Space-Pickles/2025-Electrical-2/vanguard/patrick/tardon/tardon/imports/MPU-6000/MPU-6000.step

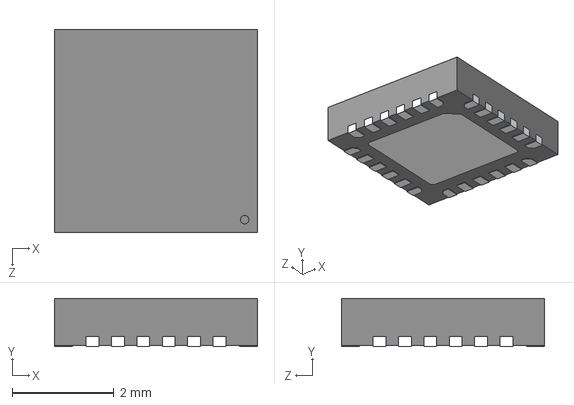
[picture p1: CAD file, 2025-04-15]
vanguard/patrick/tardon/tardon/imports/MPU-6000/MPU-6000.step
4.00 x 0.95 x 4.00 mm
