Space-Pickles/2025-Electrical-2/vanguard/board versions/Vang_V2.3.4/Vanguard_new.kicad_pcb

## KiCad design vanguard/board versions/Vang_V2.3.4/Vanguard_new.kicad_pcb (2025-05-21, an earlier design)

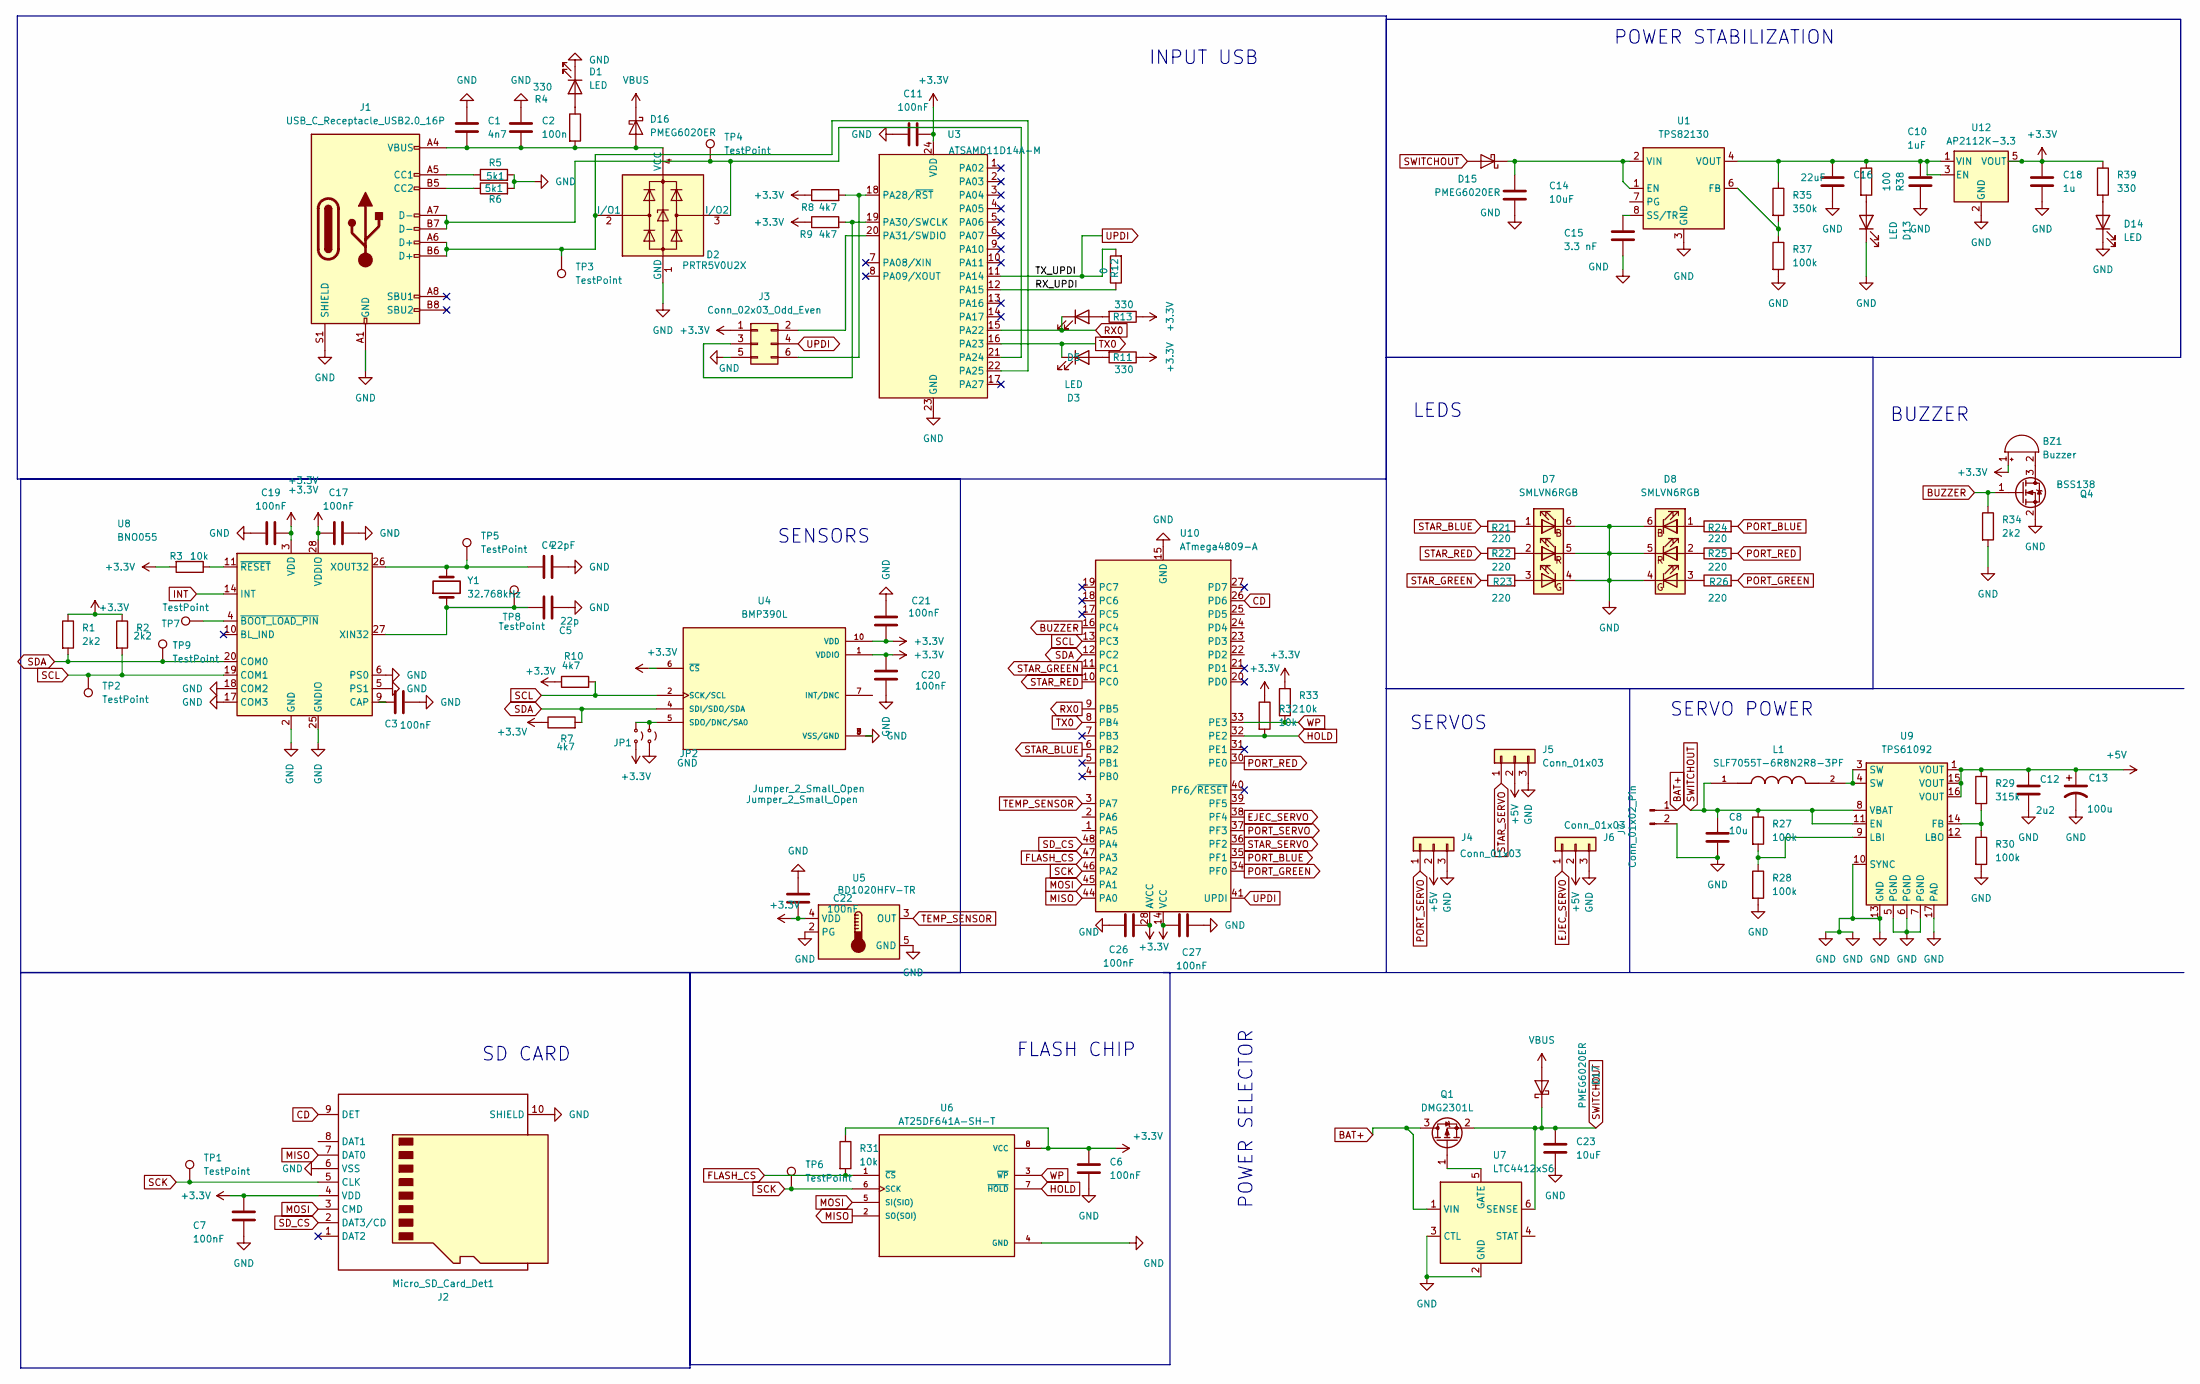
[picture p2: schematic Vanguard_new.kicad_sch]

Parts:
BZ1: Buzzer; MagneticBuzzer_PUI_AT-0927-TT-6-R
C1: 4n7; C_0603_1608Metric
C2: 100n; C_0603_1608Metric
C3, C6, C7, C11, C17, C19, C20, C21, C22, C26, C27: 100nF; C_0603_1608Metric
C4: 22pF; C_0603_1608Metric
C5: 22p; C_0603_1608Metric
C8: 10u; C_0603_1608Metric
C10: 1uF; C_0603_1608Metric
C12: 2u2; C_0603_1608Metric
C13: 100u; CP_Radial_D4.0mm_P2.00mm
C14, C23: 10uF; C_0603_1608Metric
C15: 3.3 nF; C_0603_1608Metric
C16: 22uF; C_0603_1608Metric
C18: 1u; C_0603_1608Metric
D1, D3, D5, D13, D14: LED; LED_0603_1608Metric
D2: PRTR5V0U2X; SOT-143
D7, D8: SMLVN6RGB; LED_ROHM_SMLVN6
D15, D16, D17: PMEG6020ER; Nexperia_CFP3_SOD-123W
J1: USB_C_Receptacle_USB2.0_16P; USB_C_Receptacle_Amphenol_124019772112A
J2: Micro_SD_Card_Det1; microSD_HC_Hirose_DM3D-SF
J3: Conn_02x03_Odd_Even; PinHeader_2x03_P2.54mm_Vertical
J4, J5, J6: Conn_01x03; PinHeader_1x03_P2.54mm_Vertical
J7: Conn_01x02_Pin; JST_PH_B2B-PH-K_1x02_P2.00mm_Vertical
JP1, JP2: Jumper_2_Small_Open; SolderJumper-2_P1.3mm_Open_Pad1.0x1.5mm
L1: SLF7055T-6R8N2R8-3PF; L_7.3x7.3_H4.5; PARTREV N/A
Q1: DMG2301L; SOT-23
Q4: BSS138; SOT-23
R1, R2, R34: 2k2; R_0603_1608Metric
R3, R31, R32, R33: 10k; R_0603_1608Metric
R4, R11, R13, R39: 330; R_0603_1608Metric
R5, R6: 5k1; R_0603_1608Metric
R7, R8, R9, R10: 4k7; R_0603_1608Metric
R12: 0; R_0603_1608Metric
R21, R22, R23, R24, R25, R26: 220; R_0603_1608Metric
R27, R28, R30, R37: 100k; R_0603_1608Metric
R29: 315k; R_0603_1608Metric
R35: 350k; R_0603_1608Metric
R38: 100; R_0603_1608Metric
TP1, TP2, TP3, TP4, TP5, TP6, TP7, TP8, TP9: TestPoint; TestPoint_Pad_1.0x1.0mm
U1: TPS82130; Texas_SIL0008D_MicroSiP-8-1EP_2.8x3mm_P0.65mm_EP1.1x1.9mm_T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
U3: ATSAMD11D14A-M; QFN-24-1EP_4x4mm_P0.5mm_EP2.6x2.6mm
U4: BMP390L; ST_HLGA-10_2x2mm_P0.5mm_LayoutBorder3x2y; PARTREV 1.7
U5: BD1020HFV-TR; HVSOF5
U6: AT25DF641A-SH-T; SOIC-8_3.9x4.9mm_P1.27mm; PARTREV 06-2020
U7: LTC4412xS6; TSOT-23-6
U8: BNO055; LGA-28_5.2x3.8mm_P0.5mm
U9: TPS61092; Texas_RSA_VQFN-16-1EP_4x4mm_P0.65mm_EP2.7x2.7mm_ThermalVias
U10: ATmega4809-A; TQFP-48_7x7mm_P0.5mm
U12: AP2112K-3.3; SOT-23-5
Y1: 32.768kHz; Crystal_C26-LF_D2.1mm_L6.5mm_Vertical

Connections:
+5V: C12.1, C13.1, J4.2, J5.2, J6.2, R29.1, U9.1 (VOUT), U9.15 (VOUT), U9.16 (VOUT)
/RX_UPDI: R12.1, U3.12 (PA15)
BAT+: J7.1, Q1.3 (D), U7.1 (VIN)
BUZZER: Q4.1 (G), R34.1, U10.16 (PC4)
CD: J2.9 (DET), U10.26 (PD6)
EJEC_SERVO: J6.1, U10.38 (PF4)
FLASH_CS: R31.2, U6.1 (~CS), U10.47 (PA3)
HOLD: R32.2, U6.7 (~HOLD), U10.32 (PE2)
INT: U8.14 (INT)
MISO: J2.7 (DAT0), U6.2 (SO(SOI)), U10.44 (PA0)
MOSI: J2.3 (CMD), U6.5 (SI(SIO)), U10.45 (PA1)
unnamed: BZ1.2 (-), Q4.3 (D)
unnamed: D1.2 (A), R4.1
unnamed: D2.2 (I/O1), J1.A6 (D+), J1.B6 (D+), TP3.1, U3.22 (PA25)
unnamed: D2.3 (I/O2), J1.A7 (D-), J1.B7 (D-), TP4.1, U3.21 (PA24)
unnamed: D3.2 (A), R11.2
unnamed: D5.2 (A), R13.2
unnamed: D7.1 (BA), R21.2
unnamed: D7.3 (GA), R23.2
unnamed: D7.2 (RA), R22.2
unnamed: D8.1 (BA), R24.1
unnamed: D8.3 (GA), R26.1
unnamed: D8.2 (RA), R25.1
unnamed: D13.2 (A), R38.2
unnamed: D14.2 (A), R39.2
unnamed: C14.1, D15.1 (K), U1.1 (EN), U1.2 (VIN)
unnamed: C1.2, C2.2, D2.4 (VCC), D16.2 (A), J1.A4 (VBUS), J1.A9 (VBUS), J1.B4 (VBUS), J1.B9 (VBUS), R4.2
unnamed: J1.A5 (CC1), R5.1
unnamed: J1.B5 (CC2), R6.1
unnamed: J3.2, U3.20 (PA31/SWDIO)
unnamed: J3.3, R9.2, U3.19 (PA30/SWCLK)
unnamed: J3.6, R8.2, U3.18 (PA28/~RST)
unnamed: JP1.1 (A), JP2.1 (A), U4.5 (SDO/DNC/SA0)
unnamed: L1.2, U9.3 (SW), U9.4 (SW)
unnamed: Q1.1 (G), U7.5 (GATE)
unnamed: R35.2, R37.1, U1.6 (FB)
unnamed: C15.1, U1.8 (SS/TR)
unnamed: C3.1, U8.9 (CAP)
unnamed: C5.1, TP8.1, U8.27 (XIN32), Y1.1
unnamed: C4.1, TP5.1, U8.26 (XOUT32), Y1.2
unnamed: TP7.1, U8.4 (~BOOT_LOAD_PIN)
unnamed: R3.1, U8.11 (~RESET)
unnamed: R29.2, R30.1, U9.14 (FB)
unnamed: R27.2, R28.1, U9.9 (LBI)
unnamed: C10.1, C16.1, R35.1, R38.1, U1.4 (VOUT), U1.5 (VOUT), U12.1 (VIN), U12.3 (EN)
PORT_BLUE: R24.2, U10.35 (PF1)
PORT_GREEN: R26.2, U10.34 (PF0)
PORT_RED: R25.2, U10.30 (PE0)
PORT_SERVO: J4.1, U10.37 (PF3)
RX0: D5.1 (K), U3.15 (PA22), U10.9 (PB5)
SCK: J2.5 (CLK), TP1.1, TP6.1, U6.6 (SCK), U10.46 (PA2)
SCL: R2.2, R10.2, TP2.1, U4.2 (SCK/SCL), U8.19 (COM1), U10.13 (PC3)
SDA: R1.2, R7.2, TP9.1, U4.4 (SDI/SDO/SDA), U8.20 (COM0), U10.12 (PC2)
SD_CS: J2.2 (DAT3/CD), U10.48 (PA4)
STAR_BLUE: R21.1, U10.6 (PB2)
STAR_GREEN: R23.1, U10.11 (PC1)
STAR_RED: R22.1, U10.10 (PC0)
STAR_SERVO: J5.1, U10.36 (PF2)
SWITCHOUT: C8.1, C23.1, D15.2 (A), D17.1 (K), L1.1, Q1.2 (S), R27.1, U7.6 (SENSE), U9.8 (VBAT), U9.11 (EN)
TEMP_SENSOR: U5.3 (OUT), U10.3 (PA7)
TX0: D3.1 (K), U3.16 (PA23), U10.8 (PB4)
UPDI: J3.4, R12.2, U3.11 (PA14), U10.41 (UPDI)
VBUS: D16.1 (K), D17.2 (A)
WP: R33.2, U6.3 (~WP), U10.33 (PE3)

Notes on the sheet:
BUZZER
SENSORS
POWER SELECTOR
SD CARD
INPUT USB
SERVOS
FLASH CHIP
LEDS
POWER STABILIZATION
SERVO POWER

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
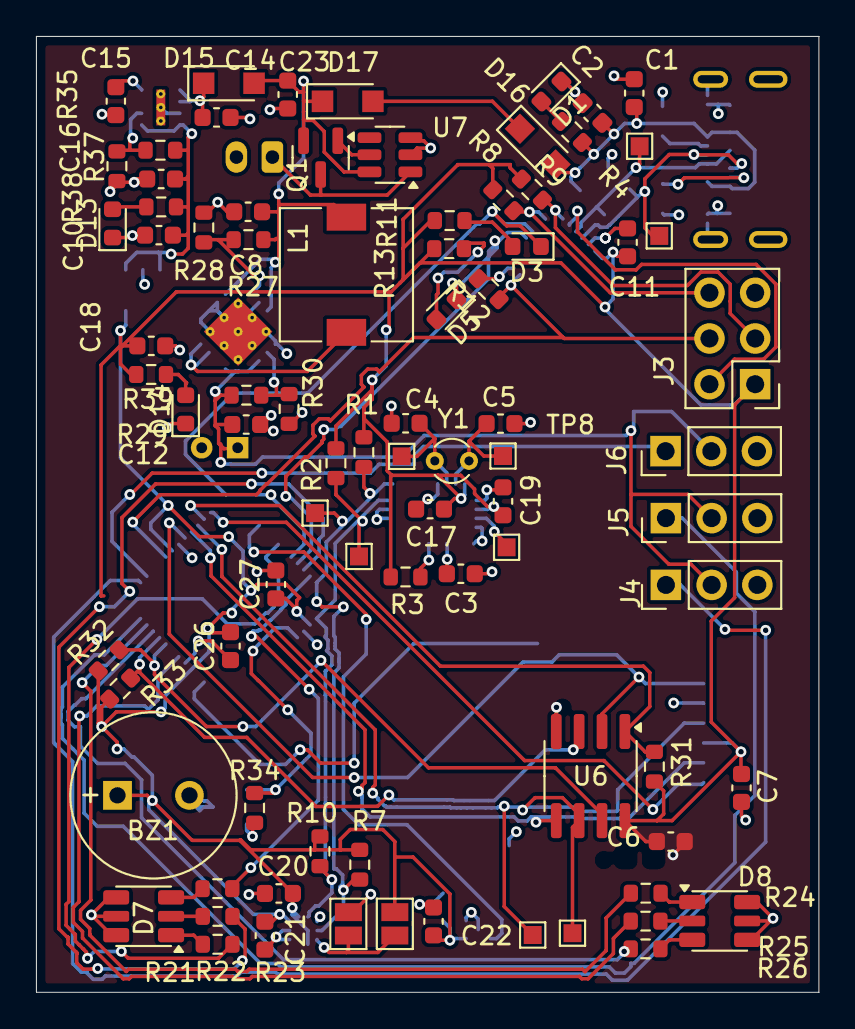
[picture p3: board vanguard/board versions/Vang_V2.3.4/Vanguard_new.kicad_pcb from above]

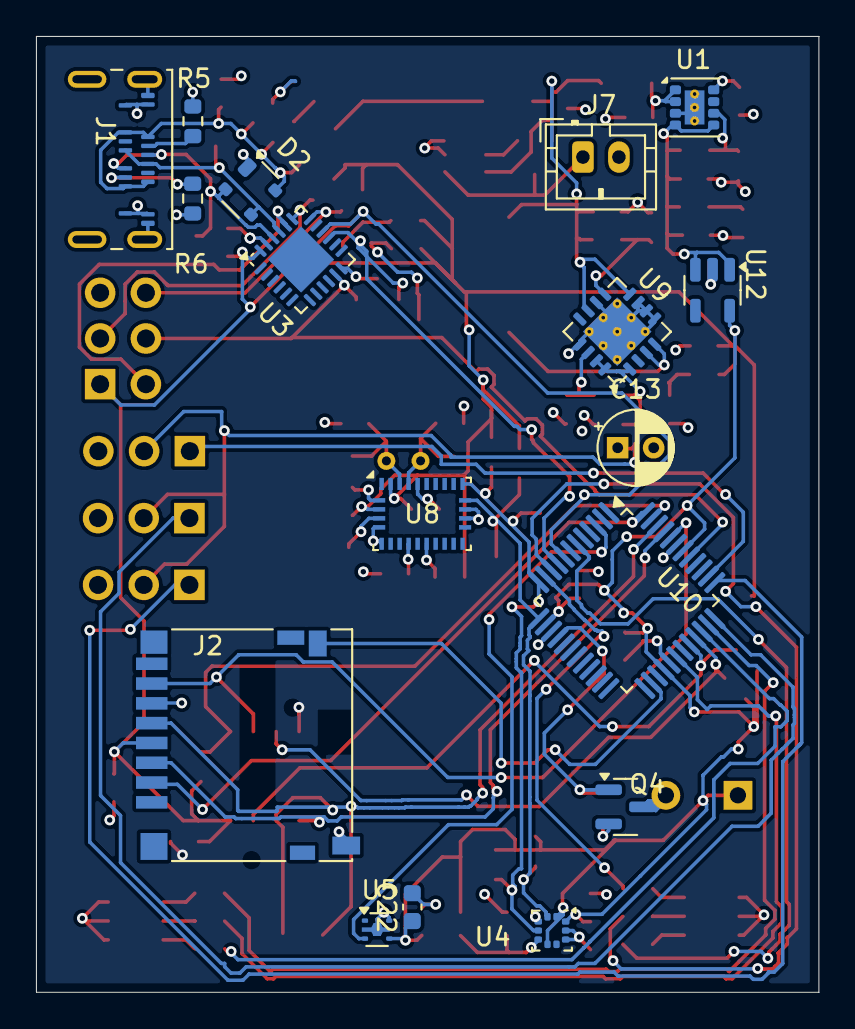
[picture p4: board vanguard/board versions/Vang_V2.3.4/Vanguard_new.kicad_pcb from below]

Board: 4 copper layers, 43.5 x 53.1 mm, 100 parts (17 on the bottom side), 65 nets.

Other parts of the board:
C22#2: 100nF; C_0603_1608Metric
