Space-Pickles/2025-Electrical-2/vanguard/patrick/Launch system/Vanguard_new.kicad_pcb

## KiCad design vanguard/patrick/Launch system/Vanguard_new.kicad_pcb (2025-04-29)

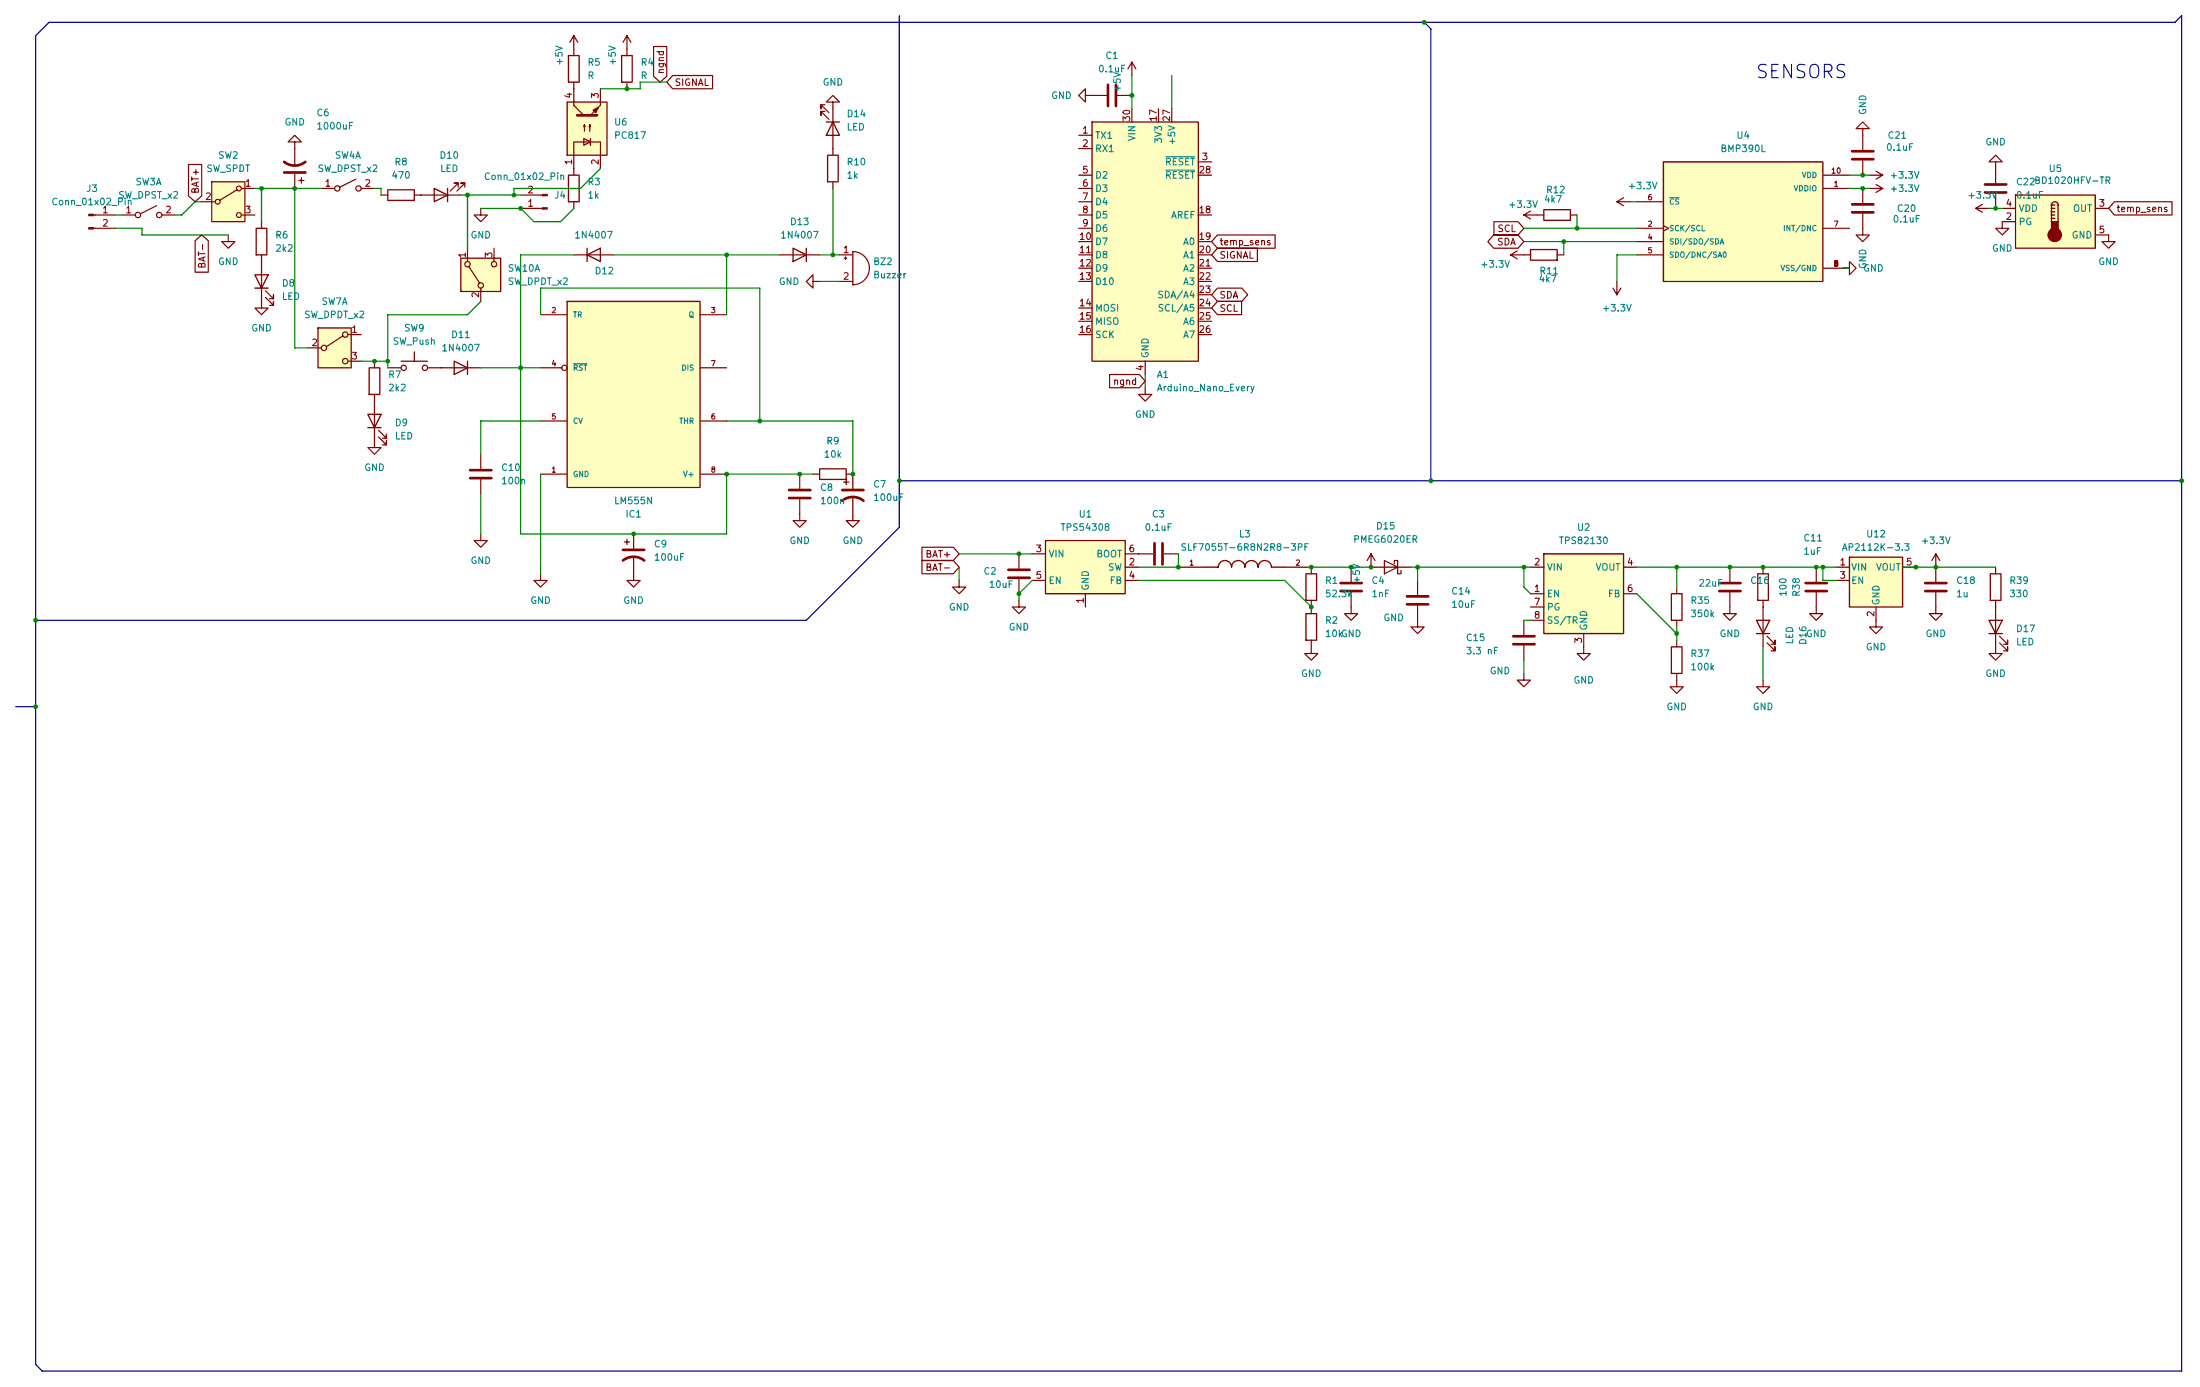
[picture p5: schematic Vanguard_new.kicad_sch]

Parts:
A1: Arduino_Nano_Every; Arduino_Nano
BZ2: Buzzer; Buzzer_12x9.5RM7.6
C1, C3, C20, C21, C22: 0.1uF; C_0805_2012Metric
C2, C14: 10uF; C_0805_2012Metric
C4: 1nF; C_0805_2012Metric
C6: 1000uF; C_0805_2012Metric
C7, C9: 100uF; C_0805_2012Metric
C8, C10: 100n; C_0805_2012Metric
C11: 1uF; C_0805_2012Metric
C15: 3.3 nF; C_0805_2012Metric
C16: 22uF; C_0805_2012Metric
C18: 1u; C_0805_2012Metric
D8, D9, D10, D14: LED; LED_D3.0mm
D11, D12, D13: 1N4007; D_SOD-123F
D15: PMEG6020ER; Nexperia_CFP3_SOD-123W
D16, D17: LED; LED_0201_0603Metric
IC1: LM555N; SOIC-8_3.9x4.9mm_P1.27mm
J3: Conn_01x02_Pin; AMASS_XT60-F_1x02_P7.20mm_Vertical
J4: Conn_01x02_Pin; PinSocket_1x02_P2.54mm_Vertical
L3: SLF7055T-6R8N2R8-3PF; L_7.3x7.3_H4.5; PARTREV N/A
R1: 52.3k; R_0805_2012Metric
R2, R9: 10k; R_0805_2012Metric
R3, R10: 1k; R_0805_2012Metric
R4, R5: R; R_0805_2012Metric
R6, R7: 2k2; R_0805_2012Metric
R8: 470; R_0805_2012Metric
R11, R12: 4k7; R_0805_2012Metric
R35: 350k; R_0805_2012Metric
R37: 100k; R_0805_2012Metric
R38: 100; R_0805_2012Metric
R39: 330; R_0805_2012Metric
SW2: SW_SPDT; PinHeader_1x03_P2.54mm_Vertical
SW3, SW4: SW_DPST_x2; PinHeader_1x02_P2.54mm_Vertical
SW7, SW10: SW_DPDT_x2; PinHeader_1x03_P2.54mm_Vertical
SW9: SW_Push; PinHeader_1x02_P2.54mm_Vertical
U1: TPS54308; SOT-23-6
U2: TPS82130; Texas_SIL0008D_MicroSiP-8-1EP_2.8x3mm_P0.65mm_EP1.1x1.9mm_T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
U4: BMP390L; ST_HLGA-10_2x2mm_P0.5mm_LayoutBorder3x2y; PARTREV 1.7
U5: BD1020HFV-TR; HVSOF5
U6: PC817; DIP-4_W7.62mm
U12: AP2112K-3.3; SOT-23-5

Connections:
+3.3V: C18.1, C20.2, C21.1, C22.2, R11.1, R12.1, R39.1, U4.1 (VDDIO), U4.5 (SDO/DNC/SA0), U4.6 (~CS), U4.10 (VDD), U5.4 (VDD), U12.5 (VOUT)
+5V: A1.30 (VIN), C1.2, C4.1, D15.2 (A), L3.2, R1.1, R4.1, R5.1
BAT+: C2.1, SW2.2 (B), SW3.2 (B), U1.3 (VIN)
BAT-: A1.4 (GND), A1.20 (A1), A1.29 (GND), BZ2.2 (-), C1.1, C2.2, C4.2, C6.2, C7.2, C8.2, C9.2, C10.2, C11.2, C14.2, C15.2, C16.2, C18.2, C20.1, C21.2, C22.1, D8.1 (K), D9.1 (K), D14.1 (K), D16.1 (K), D17.1 (K), IC1.1 (GND), J3.2, J4.1, R2.2, R3.2, R4.2, R37.2, U1.5 (EN), U2.3 (GND), U2.9 (GND), U4.3 (VSS/GND), U4.8 (VSS/GND), U4.9 (VSS/GND), U5.2 (PG), U5.5 (GND), U6.3, U12.2 (GND)
unnamed: BZ2.1 (+), D13.1 (K), R10.2
unnamed: D8.2 (A), R6.2
unnamed: D9.2 (A), R7.2
unnamed: D10.2 (A), R8.2
unnamed: D10.1 (K), J4.2, SW10.1 (A), U6.2
unnamed: D11.2 (A), SW9.2
unnamed: C8.1, C9.1, D11.1 (K), D12.1 (K), IC1.4 (~RST), IC1.8 (V+), R9.1
unnamed: D12.2 (A), D13.2 (A), IC1.3 (Q)
unnamed: D14.2 (A), R10.1
unnamed: C14.1, D15.1 (K), U2.1 (EN), U2.2 (VIN)
unnamed: D16.2 (A), R38.2
unnamed: D17.2 (A), R39.2
unnamed: C10.1, IC1.5 (CV)
unnamed: C7.1, IC1.2 (TR), IC1.6 (THR), R9.2
unnamed: J3.1, SW3.1 (A)
unnamed: R3.1, U6.1
unnamed: R5.2, U6.4
unnamed: C6.1, R6.1, SW2.1 (A), SW4.1 (A), SW7.2 (B)
unnamed: R8.1, SW4.2 (B)
unnamed: R7.1, SW7.3 (C), SW9.1, SW10.2 (B)
unnamed: C3.1, U1.6 (BOOT)
unnamed: R1.2, R2.1, U1.4 (FB)
unnamed: C3.2, L3.1, U1.2 (SW)
unnamed: R35.2, R37.1, U2.6 (FB)
unnamed: C15.1, U2.8 (SS/TR)
unnamed: C11.1, C16.1, R35.1, R38.1, U2.4 (VOUT), U2.5 (VOUT), U12.1 (VIN), U12.3 (EN)
SCL: A1.24 (SCL/A5), R12.2, U4.2 (SCK/SCL)
SDA: A1.23 (SDA/A4), R11.2, U4.4 (SDI/SDO/SDA)
temp_sens: A1.19 (A0), U5.3 (OUT)

Notes on the sheet:
SENSORS

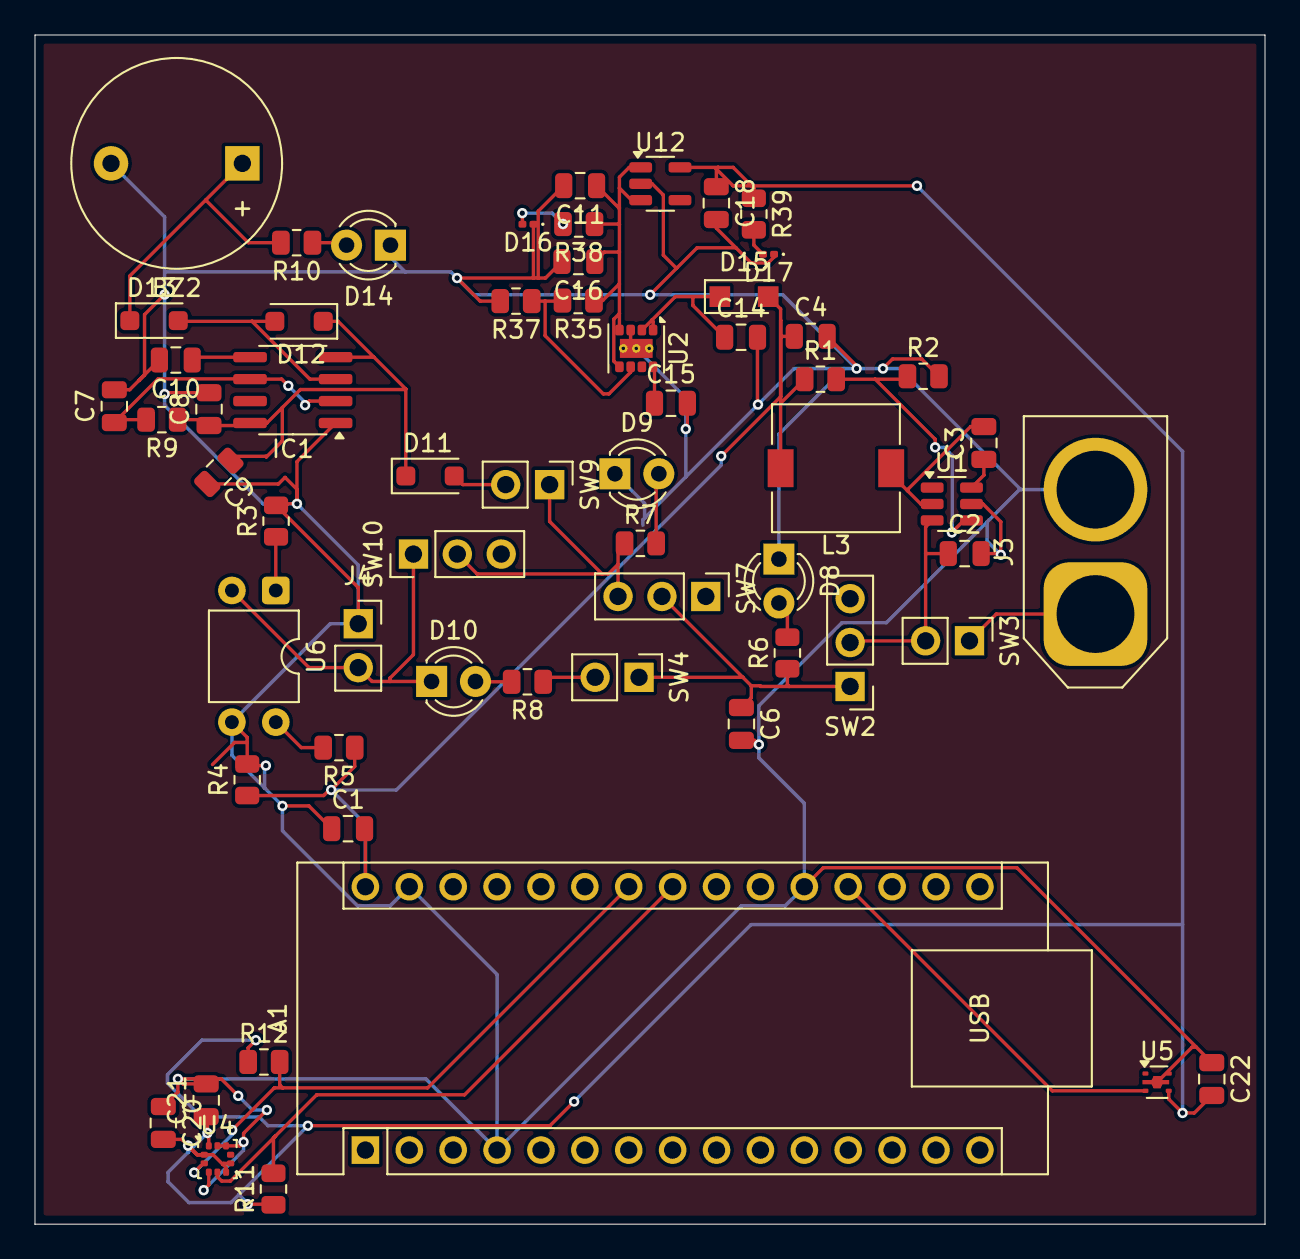
[picture p6: board vanguard/patrick/Launch system/Vanguard_new.kicad_pcb from above]

Board: 2 copper layers, 71.2 x 68.8 mm, 61 parts (0 on the bottom side), 33 nets.
