Space-Pickles/2025-Electrical-2/vanguard/board versions/Vang_V2.3.1/Vanguard_new.kicad_pcb

## KiCad design vanguard/board versions/Vang_V2.3.1/Vanguard_new.kicad_pcb (2025-02-10, an earlier design)

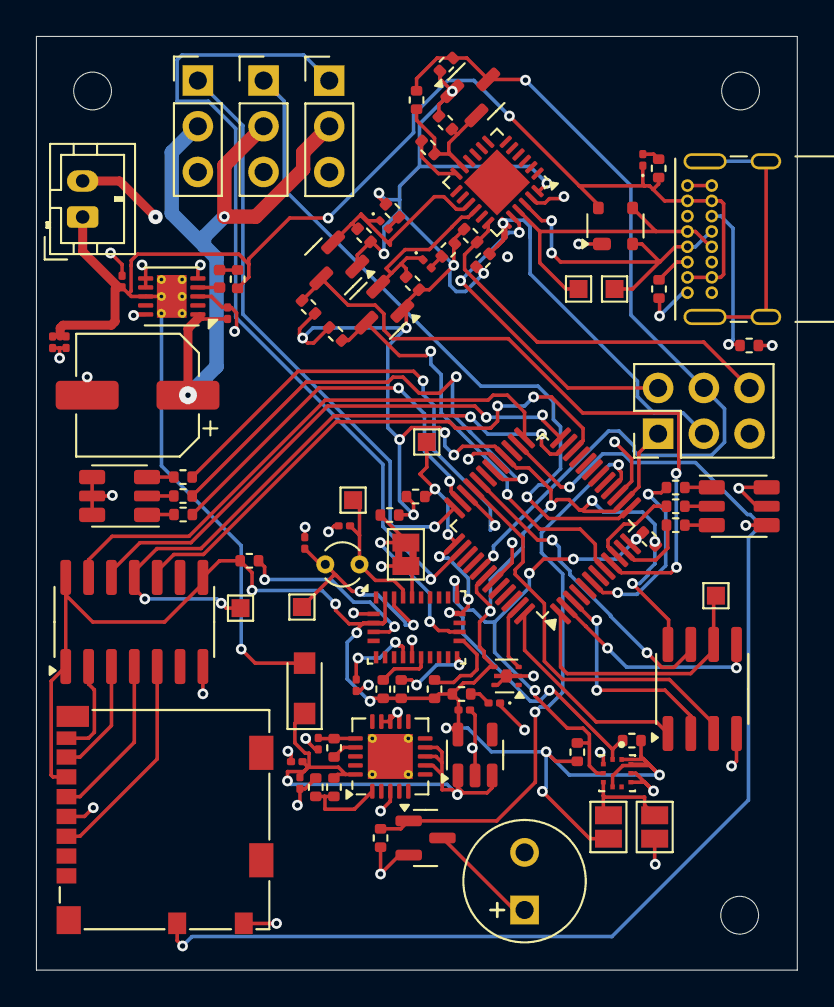
[picture p7: board vanguard/board versions/Vang_V2.3.1/Vanguard_new.kicad_pcb from above]

Board: 4 copper layers, 42.3 x 51.9 mm, 90 parts (0 on the bottom side), 72 nets.

Parts:
ADR1: SolderJumper-2_P1.3mm_Bridged2Bar_Pad1.0x1.5mm
BZ1: Buzzer; MagneticBuzzer_Kingstate_KCG0601
C2, C3: 22p; C_0201_0603Metric
C4, C5: 22u; C_0201_0603Metric
C6, C11: 1u; C_0201_0603Metric
C7: 0u1; C_0201_0603Metric
C8: 10u; C_0201_0603Metric
C9: 2u2; C_0201_0603Metric
C10: 100u; CP_Elec_6.3x5.4
C12: 4n7; C_0201_0603Metric
C13: 100n; C_0201_0603Metric
D1: PRTR5V0U2X; SOT-143
D2, D3, D7: LED; LED_0201_0603Metric
D5: GREEN; LED_0201_0603Metric
D6: PMEG6020ER; Nexperia_CFP3_SOD-123W
J1: USB_C_Receptacle_USB2.0_16P; USB_C_Receptacle_GCT_USB4085
J2: Conn_02x03_Pin; PinHeader_2x03_P2.54mm_Vertical
J3: Micro_SD_Card_Det1; microSD_HC_Molex_104031-0811
J4: STARBOARD_SERVO; PinHeader_1x03_P2.54mm_Vertical
J5: PORTSIDE_SERVO; PinHeader_1x03_P2.54mm_Vertical
J6: Battery In; JST_PH_B2B-PH-K_1x02_P2.00mm_Vertical
J7: EJECTION_SERVO; PinHeader_1x03_P2.54mm_Vertical
JP1, JP2: Jumper_2_Small_Open; SolderJumper-2_P1.3mm_Open_Pad1.0x1.5mm
L1: 6u8; L_0402_1005Metric
PORTSIDE_RGB1: SMLVN6RGB; LED_ROHM_SMLVN6
Q1, Q2, Q3, Q4: BSS138; SOT-23
R1, R36: 4.7kΩ; R_0402_1005Metric
R2, R6, R7, R9, R10, R11, R12, R13, R19, R20: 4k7; R_0402_1005Metric
R3, R4: 330; R_0402_1005Metric
R5: 0; R_0402_1005Metric
R8: DNP; R_0402_1005Metric
R14, R15: 100k; R_0402_1005Metric
R16: 19k1; R_0402_1005Metric
R17: 330R; R_0402_1005Metric
R18, R23, R24: 10k; R_0402_1005Metric
R21, R22, R34: 2k2; R_0402_1005Metric
R25, R26, R27, R28, R29, R30: 220; R_0402_1005Metric
R31, R32: 5k1; R_0402_1005Metric
R33: 5m; R_0402_1005Metric
R35: R220; R_0402_1005Metric
STARBOARD_RGB1: SMLVN6RGB; LED_ROHM_SMLVN6
TP1, TP2, TP3, TP4, TP5, TP6, TP7: TestPoint; TestPoint_Pad_1.0x1.0mm
U1: ATSAMD11D14A-M; QFN-24-1EP_4x4mm_P0.5mm_EP2.6x2.6mm
U2: ATmega4809-A; TQFP-48_7x7mm_P0.5mm
U3: AT25DF641A-SH-T; SOIC-8_3.9x4.9mm_P1.27mm
U4: AP2112K-3.3; SOT-23-5
U5: BD1020HFV; HVSOF5
U6: BNO086; LGA-28_5.2x3.8mm_P0.5mm
U7: TXB0104D; SOIC-14_3.9x8.7mm_P1.27mm
U8: TPS61092; DFN-10-1EP_3x3mm_P0.5mm_EP1.65x2.38mm_ThermalVias
U9: MPM3610AGQV-P; QFN-20-1EP_4x4mm_P0.5mm_EP2.5x2.5mm_ThermalVias
U10: BMP390L; XDCR_BMP390L
Y1: 32.768kHz; Crystal_C26-LF_D2.1mm_L6.5mm_Vertical

Connections:
+3.3V: C6.1, J2.1, J3.6 (VSS), JP2.2 (B), Q1.1 (G), Q2.1 (G), Q3.1 (G), R1.1, R2.1, R3.1, R4.1, R6.1, R7.1, R9.1, R10.1, R11.1, R12.1, R13.1, R17.1, R18.2, R19.2, R20.2, R21.1, R22.1, R23.1, R24.1, R36.1, U1.24 (VDD), U2.14 (VCC), U2.28 (AVCC), U2.42 (VCC), U3.8 (VCC), U4.5 (VOUT), U5.4 (VDD), U6.3 (VDD), U6.28 (VDDIO), U7.1 (VCCA), U7.8 (OE), U7.14 (VCCB), U10.1 (VDDIO), U10.6 (~CS), U10.10 (VDD)
+5V: C9.1, C10.1, J4.2, J5.2, J7.2, U8.1 (VOUT)
/RX_UPDI: R5.1, U1.12 (PA15)
/TX_UPDI: Q1.2 (S), R5.2, R6.2, R8.1, U1.11 (PA14)
BATT_IN: C8.1, C12.1, C13.1, D1.4 (VCC), D6.2 (A), D7.1 (K), J1.A4 (VBUS), J1.A9 (VBUS), J1.B4 (VBUS), J1.B9 (VBUS), J6.1, R33.2, R35.2, U8.8 (VBAT), U8.11 (EN)
BUZZER: Q4.1 (G), R34.1, U2.16 (PC4)
CD: J3.9 (DET), U2.26 (PD6)
D4: TP3.1, U2.23 (PD3), U7.11 (B3)
D5: U2.22 (PD2), U7.10 (B4)
D6: U2.24 (PD4), U7.12 (B2)
D7: U2.25 (PD5), U7.13 (B1)
EJEC_SERVO: J7.1, U2.38 (PF4)
GND: ADR1.1 (A), BZ1.2 (-), C2.2, C3.2, C4.2, C5.2, C6.2, C7.2, C8.2, C9.2, C10.2, C11.2, C12.2, C13.2, D1.1 (GND), D5.1 (K), J1.A1 (GND), J1.A12 (GND), J1.B1 (GND), J1.B12 (GND), J2.5, J3.4 (VDD), J3.10 (SHIELD), J4.3, J5.3, J6.2, J7.3, JP1.2 (B), PORTSIDE_RGB1.4 (GK), PORTSIDE_RGB1.5 (RK), PORTSIDE_RGB1.6 (BK), Q4.2 (S), R16.2, R31.2, R32.2, R34.2, STARBOARD_RGB1.4 (GK), STARBOARD_RGB1.5 (RK), STARBOARD_RGB1.6 (BK), U1.23 (GND), U2.15 (GND), U2.29 (GND), U2.43 (GND), U3.4 (GND), U4.2 (GND), U5.2 (PG), U5.5 (GND), U6.2 (GND), U6.10 (CLKSEL0), U6.25 (GNDIO), U7.7 (GND), U8.3 (SW), U8.5 (PGND), U8.6 (PGND), U8.7 (PGND), U8.10 (SYNC), U9.3 (AGND), U9.12 (PGND), U9.13 (PGND), U9.14 (PGND), U10.3 (VSS/GND), U10.8 (VSS/GND), U10.9 (VSS/GND)
HOLD: U2.32 (PE2), U3.7 (~HOLD)
unnamed: ADR1.2 (B), R23.2, U6.17 (SA0/H_MOSI)
unnamed: BZ1.1 (+), Q4.3 (D)
unnamed: D1.2 (I/O1), J1.A6 (D+), J1.B6 (D+), TP1.1, U1.22 (PA25)
unnamed: D1.3 (I/O2), J1.A7 (D-), J1.B7 (D-), TP2.1, U1.21 (PA24)
unnamed: D2.2 (A), R4.2
unnamed: D2.1 (K), Q3.2 (S), R9.2, U1.15 (PA22)
unnamed: D3.2 (A), R3.2
unnamed: D3.1 (K), Q2.2 (S), R10.2, U1.16 (PA23)
unnamed: D5.2 (A), R17.2
unnamed: C5.1, C11.1, D6.1 (K), R15.1, U4.1 (VIN), U4.3 (EN), U9.7 (OUT), U9.8 (OUT), U9.9 (OUT), U9.20 (OUT)
unnamed: D7.2 (A), R35.1
unnamed: J1.A5 (CC1), R31.1
unnamed: J1.B5 (CC2), R32.1
unnamed: J2.2, U1.20 (PA31/SWDIO)
unnamed: J2.3, R2.2, U1.19 (PA30/SWCLK)
unnamed: J2.6, R11.2, U1.18 (PA28/~RST)
unnamed: J3.5 (CLK), U7.4 (A3)
unnamed: J3.3 (CMD), U7.5 (A4)
unnamed: J3.7 (DAT0), U7.3 (A2)
unnamed: J3.8 (DAT1), U7.2 (A1)
unnamed: JP1.1 (A), JP2.1 (A), U10.5 (SDO/DNC/SA0)
unnamed: L1.1, R33.1
unnamed: L1.2, U8.4 (SW)
unnamed: PORTSIDE_RGB1.1 (BA), R28.1
unnamed: PORTSIDE_RGB1.3 (GA), R30.1
unnamed: PORTSIDE_RGB1.2 (RA), R29.1
unnamed: R25.2, STARBOARD_RGB1.1 (BA)
unnamed: R27.2, STARBOARD_RGB1.3 (GA)
unnamed: R26.2, STARBOARD_RGB1.2 (RA)
unnamed: C7.1, U6.9 (CAP)
unnamed: R19.1, U6.15 (ENV_SCL)
unnamed: R20.1, U6.16 (ENV_SDA)
unnamed: C3.1, TP5.1, U6.27 (XIN32), Y1.2
unnamed: C2.1, TP6.1, U6.26 (XOUT32/CLKSEL1), Y1.1
unnamed: R24.2, U6.4 (~BOOT)
unnamed: R18.1, U6.11 (~RST)
unnamed: R14.2, U9.17 (EN)
unnamed: R15.2, R16.1, U9.1 (FB)
unnamed: C4.1, R14.1, U9.16 (IN)
PA0/MISO: U2.3 (PA7), U3.2 (SO(SOI))
PA1/MOSI: U2.2 (PA6), U3.5 (SI(SIO))
PA2/SCK: TP4.1, U2.1 (PA5), U3.6 (SCK)
PA3/SS: U2.48 (PA4), U3.1 (~CS)
PORT_BLUE: R28.2, U2.35 (PF1)
PORT_GREEN: R30.2, U2.34 (PF0)
PORT_RED: R29.2, U2.30 (PE0)
PORT_SERVO: J5.1, U2.13 (PC3)
RX0: Q3.3 (D), R12.2, U2.9 (PB5)
SCL: R1.2, R22.2, TP7.1, U2.37 (PF3), U6.19 (H_SCL/SCK/RX), U10.2 (SCK/SCL)
SDA: R21.2, R36.2, U2.12 (PC2), U6.20 (H_SDA/H_MISO/TX), U10.4 (SDI/SDO/SDA)
STAR_BLUE: R25.1, U2.6 (PB2)
STAR_GREEN: R27.1, U2.11 (PC1)
STAR_RED: R26.1, U2.10 (PC0)
STAR_SERVO: J4.1, U2.36 (PF2)
TEMP_SENSOR: U2.47 (PA3), U5.3 (OUT)
TX0: Q2.3 (D), R13.2, U2.8 (PB4)
UPDI: J2.4, Q1.3 (D), R7.2, R8.2, U2.41 (UPDI)
WP: U2.33 (PE3), U3.3 (~WP)
