Space-Pickles/2025-Electrical-2/(commit log)

2025-01-29 all old kicad files v2.3
    [Vanguard_new-B_Cu.gbr, Vanguard_new-B_Mask.gbr, Vanguard_new-B_Paste.gbr, Vanguard_new-B_Silkscreen.gbr, Vanguard_new-Edge_Cuts.gbr, Vanguard_new-F_Cu.gbr, Vanguard_new-F_Mask.gbr, Vanguard_new-F_Paste.gbr]
2025-01-29 clean up files
    [Vanguard_new-B_Cu.gbr, Vanguard_new-B_Mask.gbr, Vanguard_new-B_Paste.gbr, Vanguard_new-B_Silkscreen.gbr, Vanguard_new-Edge_Cuts.gbr, Vanguard_new-F_Cu.gbr, Vanguard_new-F_Mask.gbr, Vanguard_new-F_Paste.gbr]
2025-01-29 Chnaged the led seires to parallel
    [Vanguard_new.kicad_sch]
2025-01-29 KiCAD closed
2025-01-29 moved a label and closed Kicad
    [Vanguard_new.kicad_sch]
2025-01-29 removed usbc shield hybrid ground + small changes
    [Vanguard_new.kicad_pcb, Vanguard_new.kicad_sch]
2025-01-31 fiverr corrections
    [Vanguard_new.kicad_pcb, Vanguard_new.kicad_sch]
2025-01-31 wiring, fiverr, etc
    [Vanguard_new.kicad_pcb, Vanguard_new.kicad_sch]
2025-02-01 added caps and reistor for emi and esd protection
    [Vanguard_new.kicad_sch]
2025-02-01 removed a reductant vbus connection
    [Vanguard_new.kicad_sch]
2025-02-01 missed gnd wiring
    [Vanguard_new.kicad_pcb, Vanguard_new.kicad_sch]
2025-02-01 closed kicad
    [Vanguard_new.kicad_pcb]
2025-02-03 kicad opened
2025-02-03 ran drc and assign footprints
    [Vanguard_new.kicad_sch]
2025-02-03 ran sch parity test and assigned a footprint for U9
    [Vanguard_new.kicad_sch]
2025-02-03 kicad open
2025-02-03 parity test
    [Vanguard_new.kicad_pcb]
2025-02-03 Force revert commit 97deb62d1ea49336f955e200c1b09f92d203a31d
    [Vanguard_new.kicad_sch]
2025-02-03 wired u9 + new drc rules
    [JLCPCB.kicad_pcb, JLCPCB.kicad_sch, Vanguard_new.kicad_pcb]
2025-02-04 fix wiring fixed meddyfix wiring fixed meddyfix wiring fixed meddyfix wiring fixed meddyfix wiring fixed meddyfix wiring fixed meddyfix wiring fixed meddyfix wiring fixed meddyfix wiring fixed meddyf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
    [Vanguard_new.kicad_pcb]
2025-02-04 i forgot what i did
    [Vanguard_new.kicad_pcb]
2025-02-04 new footprint bmp
2025-02-05 i2c adress changes
    [Vanguard_new.kicad_sch]
2025-02-05 wired mpl370l
    [Vanguard_new.kicad_pcb, Vanguard_new.kicad_sch]
2025-02-05 v2.3.2 starting(do not touch)
    [Vanguard_new.kicad_pcb, Vanguard_new.kicad_sch]
2025-02-06 added bom text file
    [Vanguard_new.csv]
2025-02-06 pcb; patrick pls check
    [Vanguard_new.kicad_pcb, Vanguard_new.kicad_sch]
2025-02-08 moved crystal + shortened traces
    [Vanguard_new.kicad_pcb]
2025-02-10 jst ph battery connector inserted- closeout ready for 5ver review
    [Vanguard_new.kicad_pcb, Vanguard_new.kicad_sch]
2025-02-13 changed the BOM
    This reverts commit 83a17ff5912717486ecf69fb1dc7ab8473ef6f21.
    [Vanguard_new.csv]
2025-02-27 production folder
    [Vanguard_new.csv, Vanguard_new.kicad_pcb, Vanguard_new.kicad_sch]
2025-02-27 cleaned production folder
    [Vanguard_new.csv]
2025-02-28 PRODUCTION + BOMB
    [Vanguard_new-B_Cu.gbr, Vanguard_new-B_Mask.gbr, Vanguard_new-B_Paste.gbr, Vanguard_new-B_Silkscreen.gbr, Vanguard_new-Edge_Cuts.gbr, Vanguard_new-F_Cu.gbr, Vanguard_new-F_Mask.gbr, Vanguard_new-F_Paste.gbr]
2025-03-04 schematic upload
2025-03-06 new folder for usbc
    [Vanguard_new-B_Cu.gbr, Vanguard_new-B_Mask.gbr, Vanguard_new-B_Paste.gbr, Vanguard_new-B_Silkscreen.gbr, Vanguard_new-Edge_Cuts.gbr, Vanguard_new-F_Cu.gbr, Vanguard_new-F_Mask.gbr, Vanguard_new-F_Paste.gbr]
2025-03-06 changed footprint
    [Vanguard_new.kicad_pcb]
2025-03-07 imported footprint
2025-03-07 updated parts
    [Vanguard_new.kicad_pcb, Vanguard_new.kicad_sch]
2025-03-07 prod files
    [Vanguard_new-B_Cu.gbr, Vanguard_new-B_Mask.gbr, Vanguard_new-B_Paste.gbr, Vanguard_new-B_Silkscreen.gbr, Vanguard_new-Edge_Cuts.gbr, Vanguard_new-F_Cu.gbr, Vanguard_new-F_Mask.gbr, Vanguard_new-F_Paste.gbr]
2025-03-11 + protoboard directory
    [JLCPCB.kicad_pcb, JLCPCB.kicad_sch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]
2025-03-14 2.4.2 creation
    [Vanguard_new.kicad_pcb, Vanguard_new.kicad_sch, bom.csv, designators.csv, positions.csv]
2025-03-14 Added BNO055
    [Vanguard_new.kicad_sch]
2025-03-14 BNO055 connections done!!
    [Vanguard_new.kicad_sch]
2025-03-14 checked BNO055 footprints
    [Vanguard_new.kicad_sch]
2025-03-14 Added a buzzer and a voltage regulator, imported symbols
    [Vanguard_new.kicad_sch]
2025-03-15 Opened KICAd
    [Vanguard_new.kicad_sch]
2025-03-15 buck regulator added
    [Vanguard_new.kicad_sch]
2025-03-15 Buck convertor schematic done!
    [Vanguard_new.kicad_sch]
2025-03-15 added an led footprint
    [Vanguard_new.kicad_sch]
2025-03-16 Changed resistor
    [Vanguard_new.kicad_sch]
2025-03-16 Assigned some footprints and annotated
    [Vanguard_new.kicad_sch]
2025-03-16 Added inductor attributes
    [Vanguard_new.kicad_sch]
2025-03-16 footprint config
2025-03-16 footprint config -2
2025-03-17 SMDRI127-6R8NT symbol created and added to the library
    [Vanguard_new.kicad_sch]
2025-03-17 removed new comp and rename BD1020HFV to BD1020HFV-TR
    [Vanguard_new.kicad_sch]
2025-03-17 moved text
    [Vanguard_new.kicad_sch]
2025-03-17 added CMI-1295-0585T[1]
    [Vanguard_new.kicad_sch]
2025-03-17 added inductor and buck convertor
    [Vanguard_new.kicad_sch]
2025-03-17 BNO055 assigned
    [Vanguard_new.kicad_sch]
2025-03-17 changed buzzer circuit
    [Vanguard_new.kicad_sch]
2025-03-17 changed inductor circuit
    [Vanguard_new.kicad_sch]
2025-03-17 Input USB - r and c assign
    [Vanguard_new.kicad_sch]
2025-03-17 power stabilization
    [Vanguard_new.kicad_sch]
2025-03-17 leds starboard
    [Vanguard_new.kicad_sch]
2025-03-17 sensor - r and c values + a testpoint at boot pin
    [Vanguard_new.kicad_sch]
2025-03-17 servo power r&c
    [Vanguard_new.kicad_sch]
2025-03-17 usb c footpinrt
    [Vanguard_new.kicad_sch]
2025-03-17 its footprint files
2025-03-17 inductor footprint thing
2025-03-17 the inductor footprint assigned
    Thank GOD!!! hoho! after 34 hours!
    [Vanguard_new.kicad_sch]
2025-03-17 buzzer footprint assigned!
    [Vanguard_new.kicad_sch]
2025-03-17 assigned barometer footprint
    [Vanguard_new.kicad_sch]
2025-03-21 added button switch
    [Vanguard_new.kicad_sch]
2025-03-31 2.3.2 created, 2.4.1 removed
    [Vanguard_new.csv, Vanguard_new.kicad_pcb, Vanguard_new.kicad_sch, bom.csv, designators.csv, positions.csv]
2025-04-11 opened schematic
    [Vanguard_new.kicad_sch]
2025-04-11 buzzer fix
    [Vanguard_new.kicad_sch]
2025-04-14 fixes i forgot
    [Vanguard_new.kicad_sch]
2025-04-14 moved files, cleaned up. imported stuff might need to be re done
    [Vanguard_new.csv, Vanguard_new.kicad_pcb, Vanguard_new.kicad_sch, bom.csv, designators.csv, positions.csv]
2025-04-15 moved 1 file
    [MPU-6000.step, launch.kicad_pcb, launch.kicad_sch, tardon.kicad_pcb, tardon.kicad_sch]
2025-04-15 updated sch caps
    [Vanguard_new.kicad_sch]
2025-04-16 schematic changes
    [tardon.kicad_sch]
2025-04-21 2.3.3 fix
    [Vanguard_new.kicad_pcb, Vanguard_new.kicad_sch, pr.kicad_pcb, pr.kicad_sch]
2025-04-22 made fixes check description
    Removed TXB0104D(image)
    removed the level shifting mosfets
    U11 - changed r35 from 124k to 350, should get the output voltage up
    added shield gnd
    I also reassigned pins on the main mcu
    [Vanguard_new-B_Cu.gbr, Vanguard_new-B_Mask.gbr, Vanguard_new-B_Paste.gbr, Vanguard_new-B_Silkscreen.gbr, Vanguard_new-Edge_Cuts.gbr, Vanguard_new-F_Cu.gbr, Vanguard_new-F_Mask.gbr, Vanguard_new-F_Paste.gbr]
2025-04-24 finished input usb
    [Vanguard_new.kicad_pcb, Vanguard_new.kicad_sch, bom.csv, designators.csv, positions.csv]
2025-04-25 started pcb
    [Vanguard_new.kicad_pcb, Vanguard_new.kicad_sch]
2025-04-26 dont touch yet
    [Vanguard_new.kicad_pcb]
2025-04-26 save spot
    [Vanguard_new.kicad_pcb]
2025-04-26 wiring done
    [Vanguard_new.kicad_pcb, Vanguard_new.kicad_sch]
2025-04-26 fixed drc, the rest is bs
    [Vanguard_new.kicad_pcb, Vanguard_new.kicad_sch]
2025-04-27 added power switch
    [Vanguard_new.kicad_pcb, Vanguard_new.kicad_sch, bom.csv, designators.csv, positions.csv]
2025-04-27 2.3.4 ideal diode or and finished pcb layout
    [Vanguard_new.kicad_pcb, Vanguard_new.kicad_sch]
2025-04-27 finished everything
    [Vanguard_new.kicad_pcb, Vanguard_new.kicad_sch, bom.csv, designators.csv, positions.csv]
2025-04-29 minor changes
    [Vanguard_new.kicad_sch]
2025-05-07 bom + minor fixes
    [MPU-6000.step, Vanguard_new.kicad_pcb, Vanguard_new.kicad_sch, bom.csv, designators.csv, launch.kicad_pcb, launch.kicad_sch, positions.csv]
2025-05-21 production error
    [Vanguard_new.kicad_pcb, Vanguard_new.kicad_sch, bom - bom (1).csv, bom.csv, positions.csv]
